finalyearprojectbeamtechvest/vest-tracker-system/documentation/WORD/UserGuide.docx

User Guide

Use this guide the first time you set up the system and for daily operation.

UG1. Before you start (quick checklist)

1. Vest unit battery is charged
2. Receiver and base station are powered and has Wi‑Fi to reach Firebase
3. Phone has the Vest Tracker APK installed and internet access
4. You have Firebase RTDB URL, account email/password, and the account UID

UG2. Getting started (first-time setup)

STEP 1) Charge the vest unit

1. Use the approved charger for your battery pack.
2. Disconnect when fully charged per charger instructions.
3. Reinstall the pack in the vest if you removed it for charging.

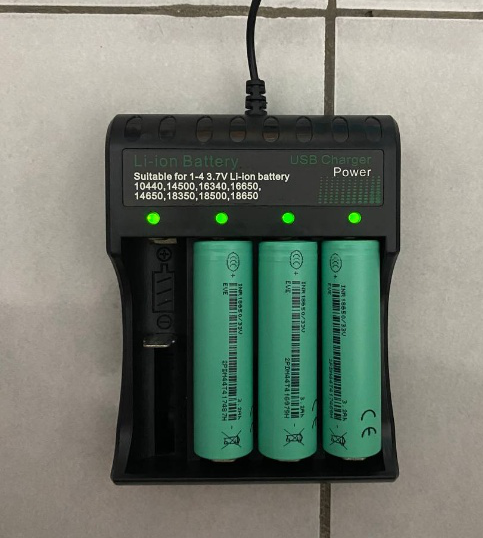
[picture p12: figure]
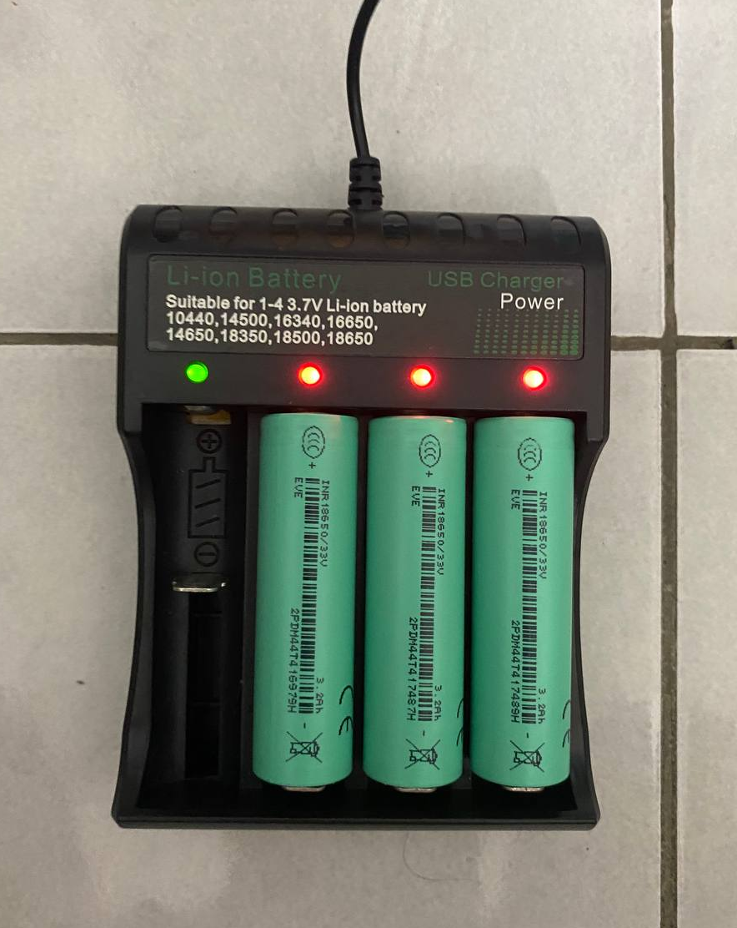
[picture p13: figure]
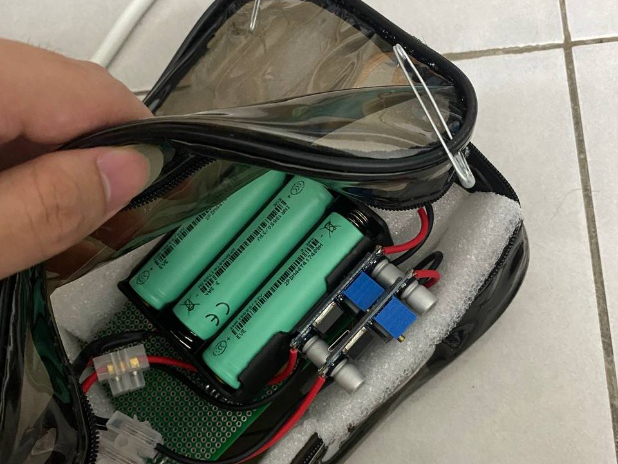
[picture p14: figure]

STEP 2) Sign in

1. Open Vest Tracker app.
2. Enter email, password, and UID on the sign-in screen (UID must match Firebase Auth and your Allowed UID field).
3. Enable Remember me only on devices you trust.
4. Tap Sign in.


STEP 3) Configure the mobile app

1. Tap Profile in the bottom navigation.
2. Under App settings, enter your Firebase RTDB URL and Allowed UID
3. Optionally set Selected device ID (e.g. device_01) or leave blank to watch all vests.
4. Tap Save settings.

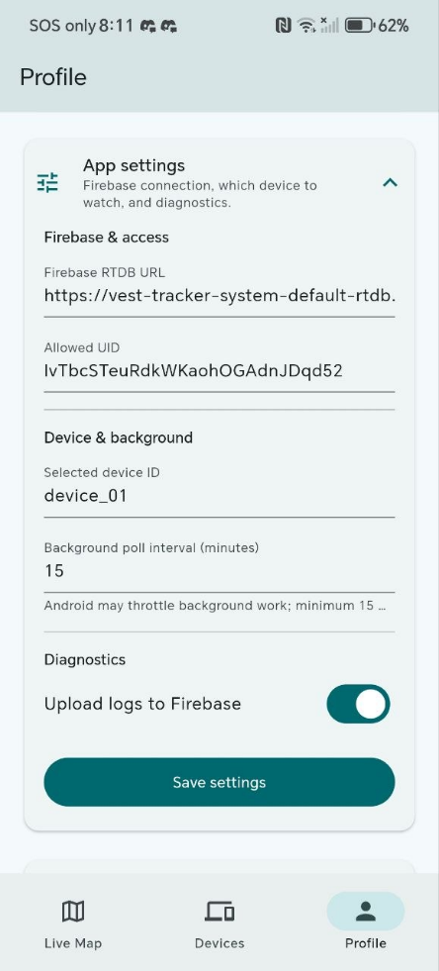
[picture p15: figure]
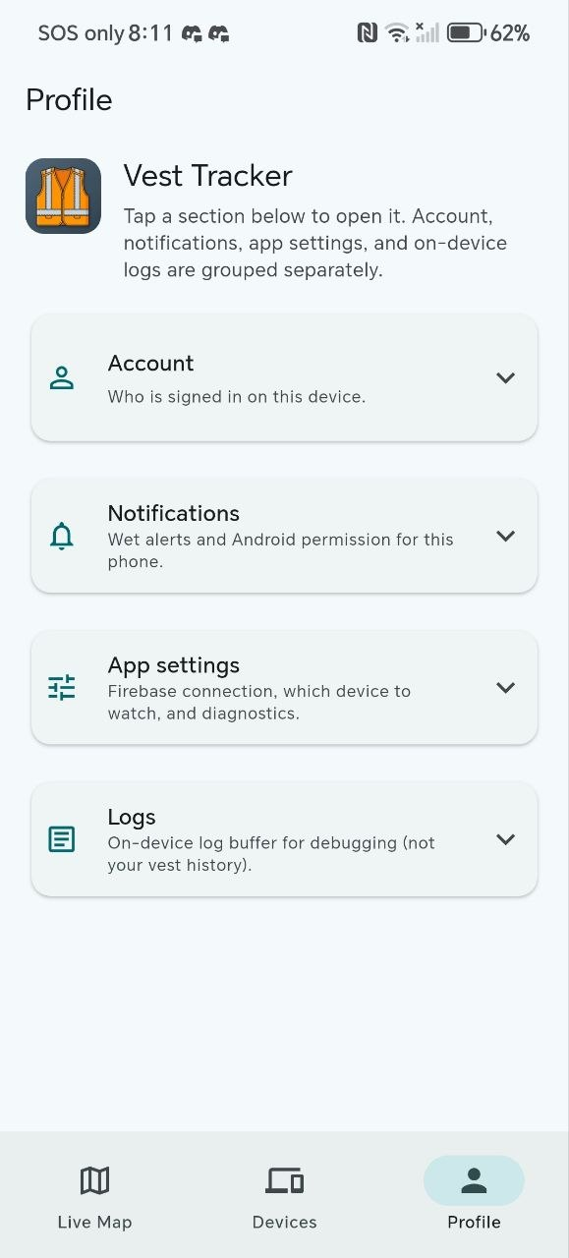
[picture p16: figure]

STEP 4) Turn on the vest unit

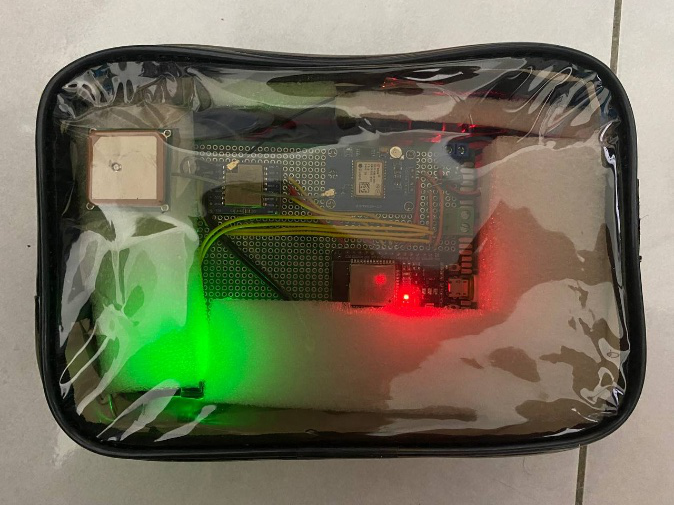
[picture p17: figure]

1. Use the vest power switch.

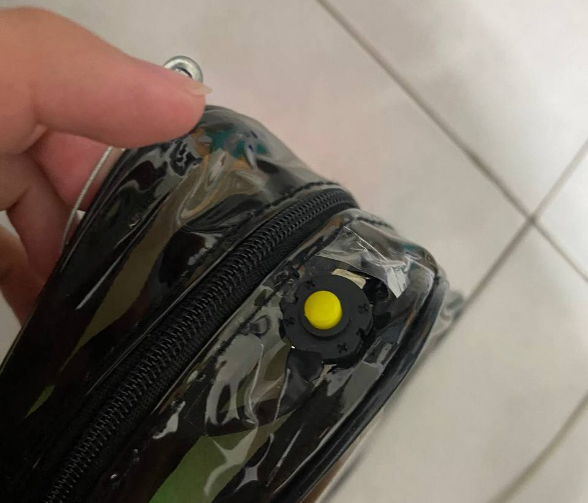
[picture p18: figure]

2. Allow 1–2 minutes outdoors for a first GPS lock (cold starts can take several minutes in difficult sky conditions). When its locked, the GPS will start blinking.

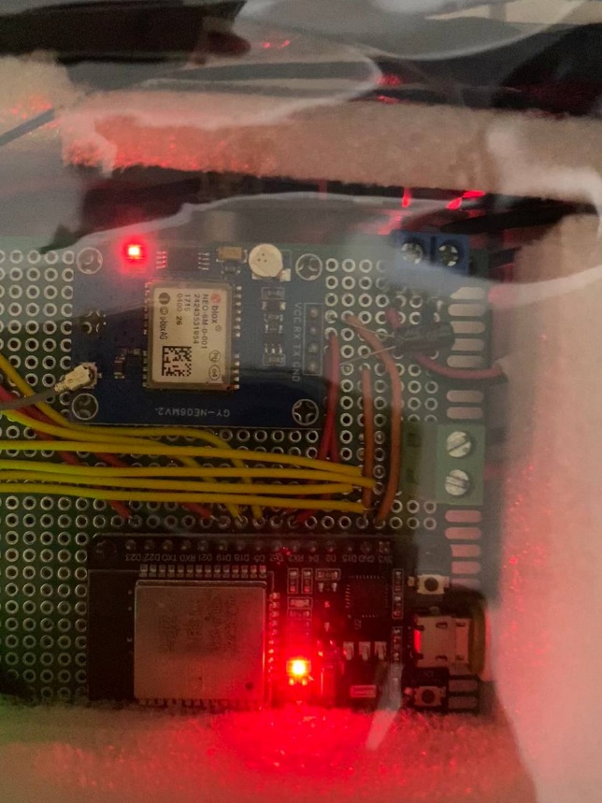
[picture p19: figure]
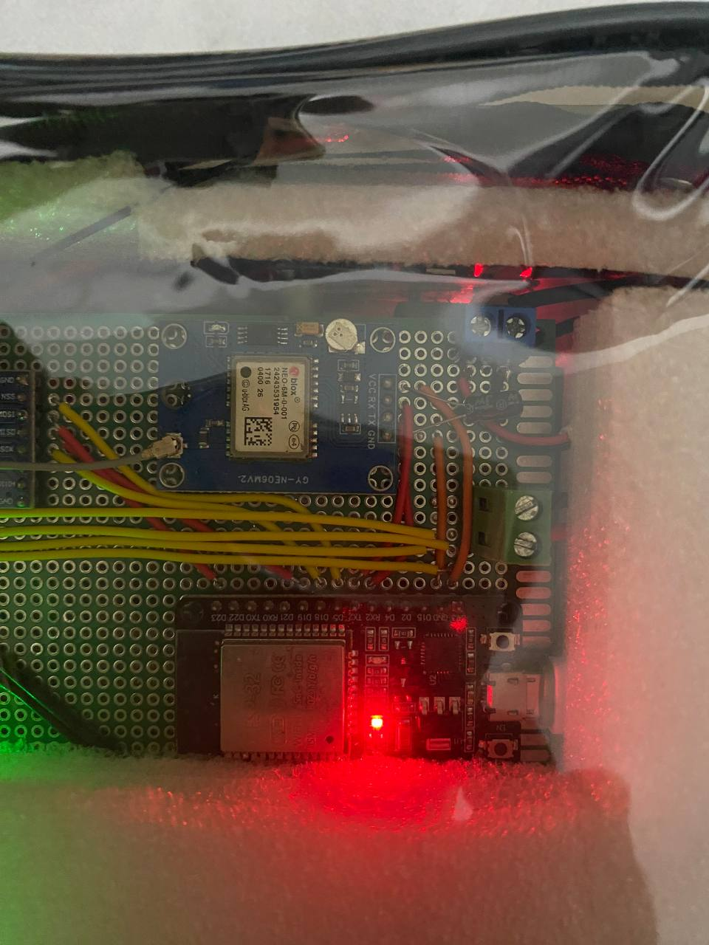
[picture p20: figure]

STEP 5) Turn on the receiver / base station

1. Apply power (USB adapter or approved supply).
2. Leave it on during tracking sessions.

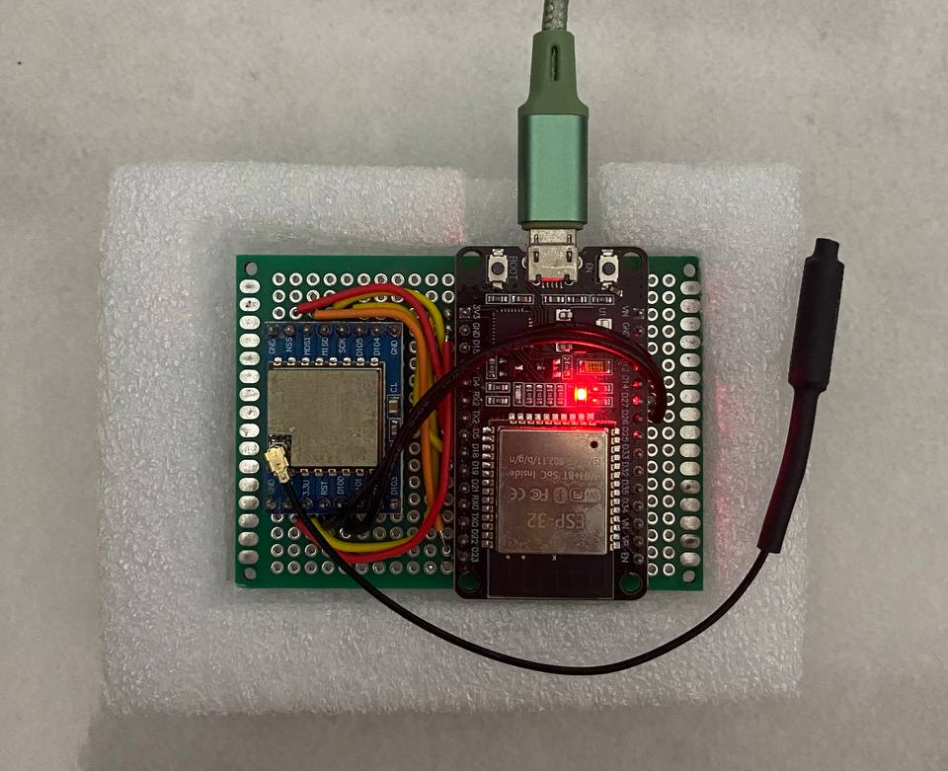
[picture p21: figure]

3. Make sure to enable Hotspot nearby with predetermined Hotspot ID and Password

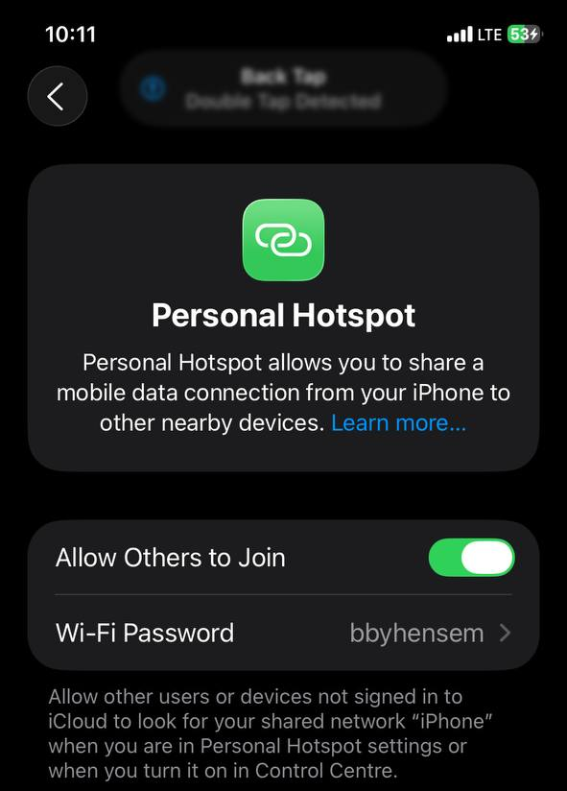
[picture p22: figure]

STEP 6) Verify in the app

1. Open Live Map. You should see markers when vests report `lat`/`lon`.

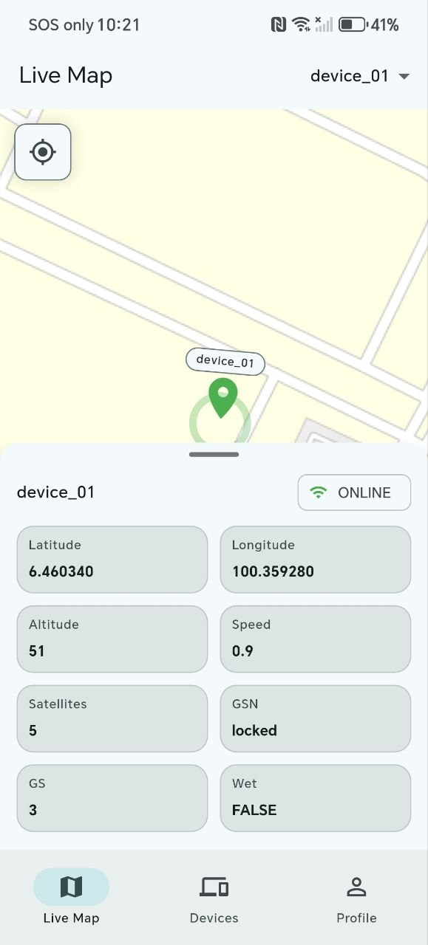
[picture p23: figure]
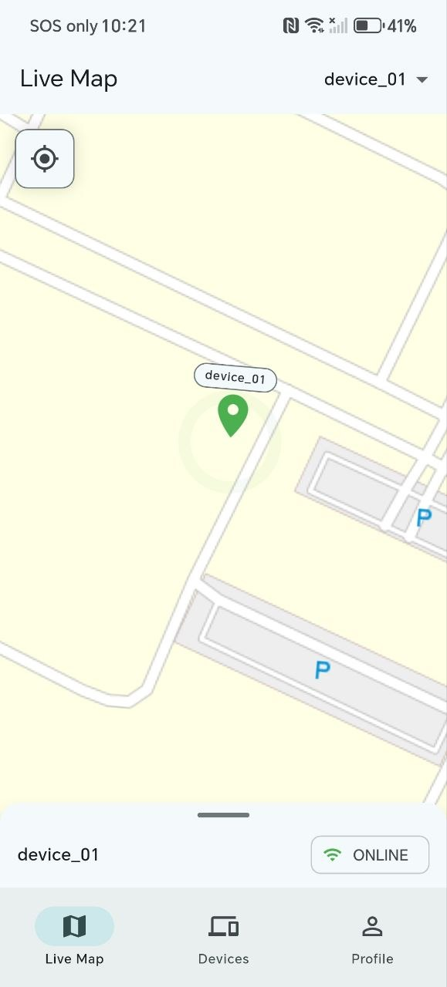
[picture p24: figure]

2. Open Devices to confirm each `device_XX` row updates last seen over time.

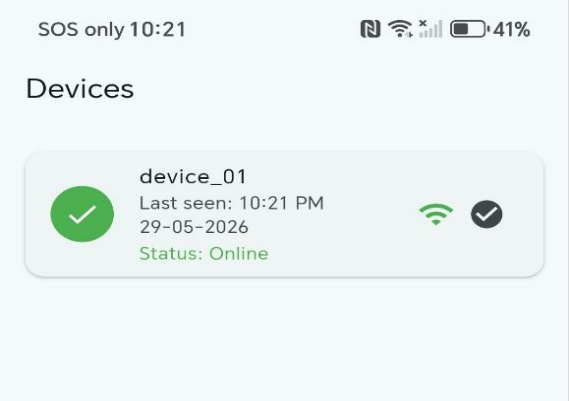
[picture p25: figure]

3. Under Profile > Notifications, confirm Android notification permission if you want wet alerts.

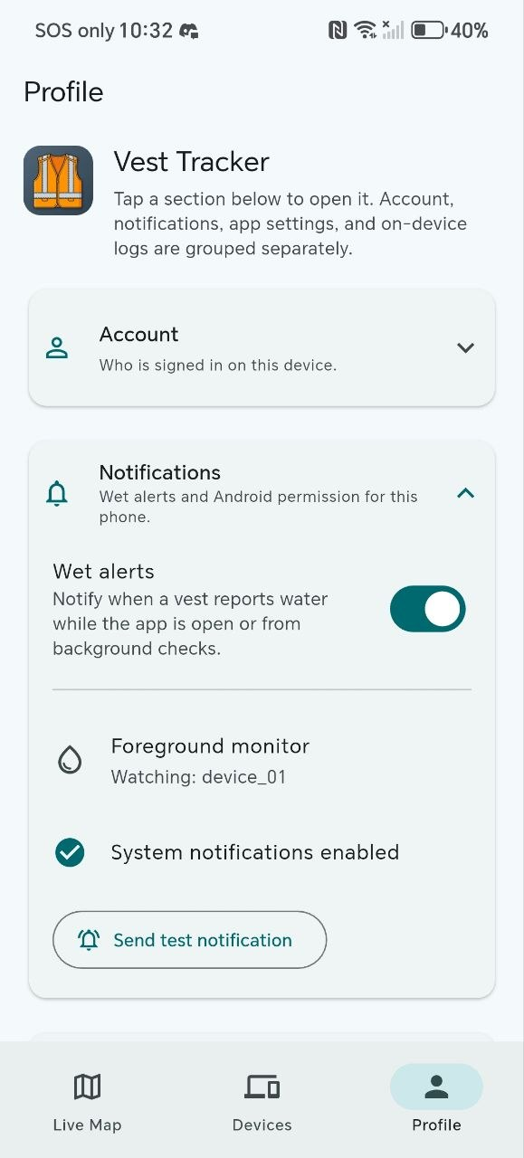
[picture p26: figure]

UG3. Normal operation (daily use)

1. Check vest location
2. Open Live Map.
3. Use the device filter in the app bar if you have multiple vests.
4. Tap a marker to open the detail sheet. use recenter if you panned away. If the marker is missing or stale, see TroubleshootingGuide.pdf.

UG4. Read device stats

1. Open Devices:
  a) Online (green) means a telemetry timestamp arrived within roughly the last 10 minutes (app-side heuristic).
  b) Offline (red) means no recent timestamp, check receiver power, LoRa range, or Wi‑Fi on the base.
  c) WET chip means the latest `wet` flag is true.

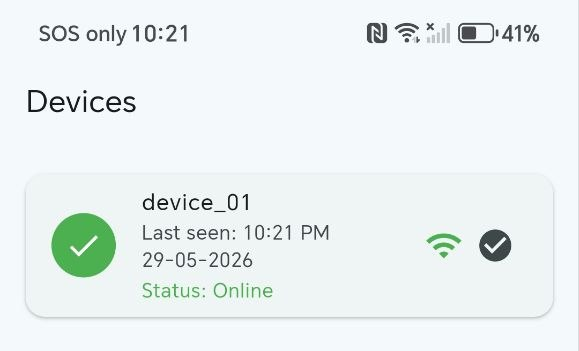
[picture p27: figure]
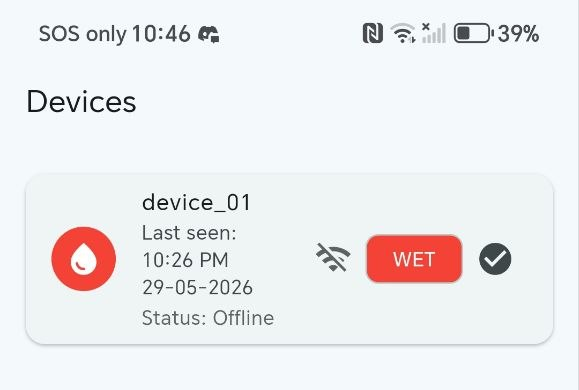
[picture p28: figure]

UG5. Understand GPS from the map

1. Markers require valid coordinates in Firebase. No marker often means no GPS fix yet, not necessarily a dead radio link.
2. Take the vest to open sky and wait several minutes (~5 mins) before assuming a hardware fault.

UG6. Wet / rain alerts

1. When notifications are enabled, the app alerts on a new wet detection (dry to wet). Dry the sensor area if the alert persists.
2. To make sure notifications works, use send test notification in Profile > Notifications first.
3. To ensure notifications are always delivered promptly, keep the app running in the background. Notifications can still be received when the app is not running, but the response time will depend on the polling interval, which may take at least 15 minutes.

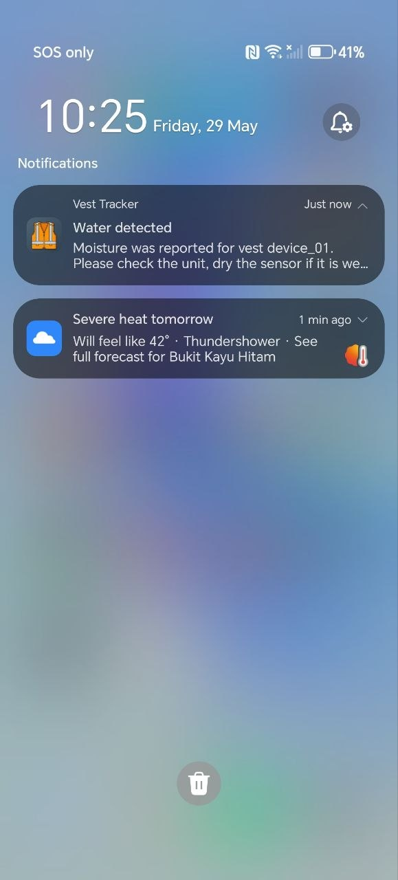
[picture p29: figure]
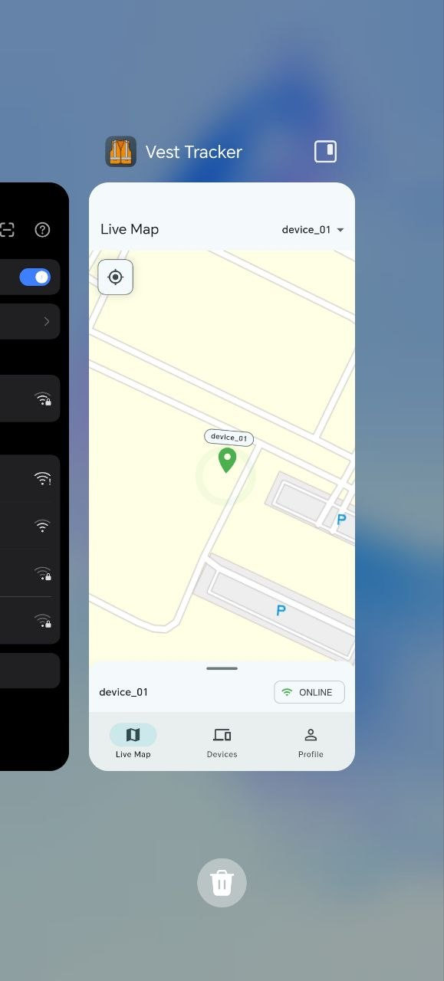
[picture p30: figure]

UG7. Daily usage tips (best results)

1. Vest placement
  a) For reliable GPS, keep the vest outside or under open sky.
  b) Avoid covering the GPS antenna area with metal or thick wet fabric for long periods.
2. Receiver placement
  a) Keep it powered continuously during use.
  b) Elevate the receiver and keep a clearer path toward the operating area (range depends on terrain and buildings).
3. Battery discipline
  a) Charge regularly. Low battery can cause brownouts or reboot loops on the vest.

UG8. Where to read more

1. MobileApp.pdf: permissions, tabs, sign-in details
2. Hardware.pdf: what each module does (non-wiring)
3. PowerSafetyNotes.pdf: charging and lithium safety
4. SystemArchitecture.pdf: data path vest to Firebase to app
5. Appendix.pdf: BOM and wiring for maintainers
